Mihirung/Dominoid/output/dominoid_A_face.png

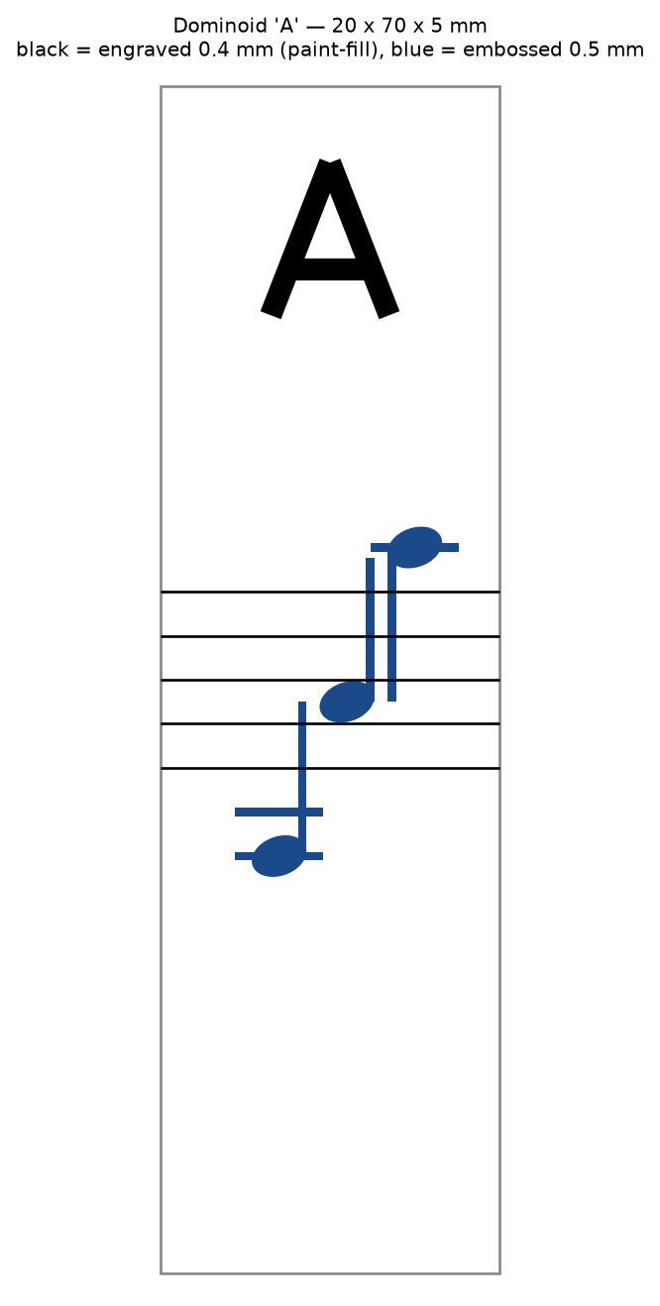
output/dominoid_A_face.png
