Mihirung/Dominoid/output/dominoid_B_flat_face.png

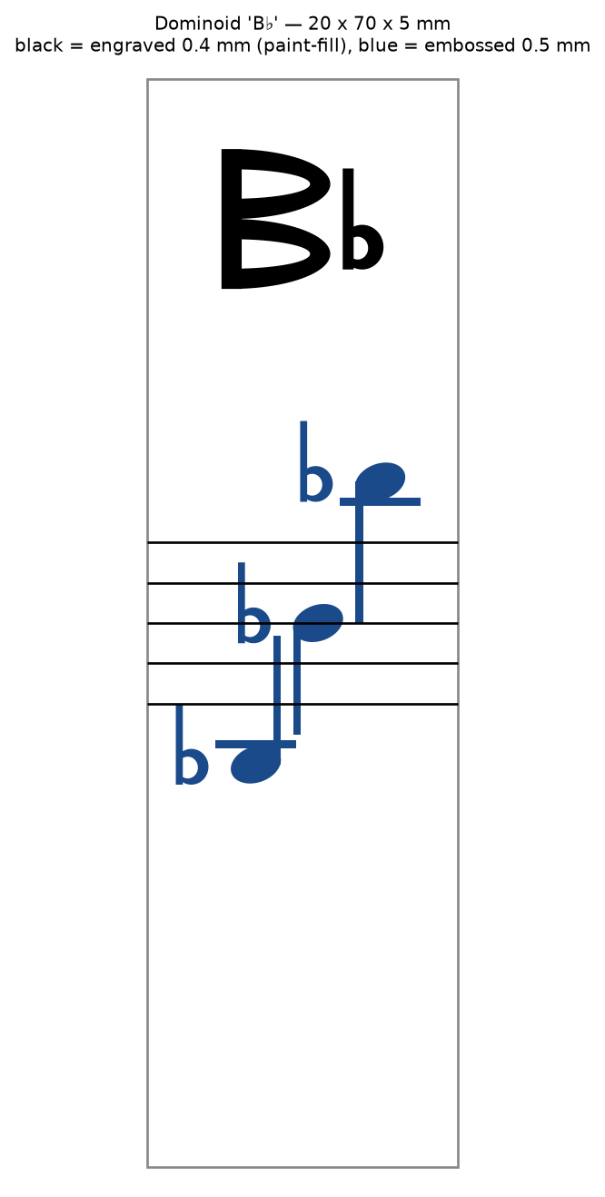
output/dominoid_B_flat_face.png
