Mihirung/Dominoid/output/dominoid_C_face.png

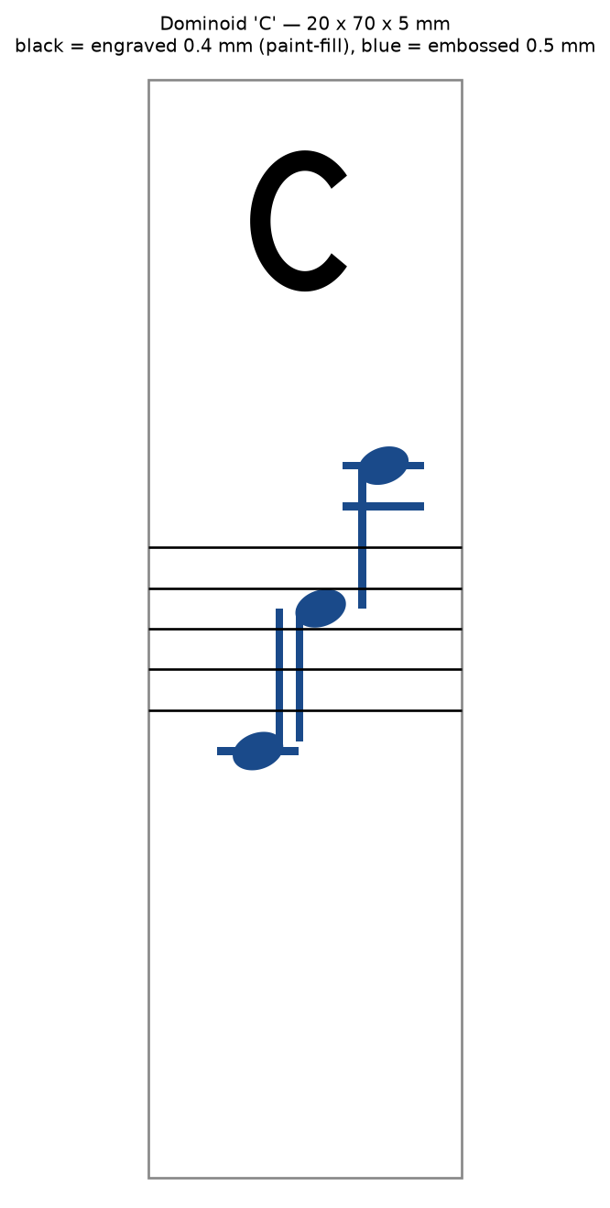
output/dominoid_C_face.png
