Mihirung/Dominoid/output/dominoid_C_render.png

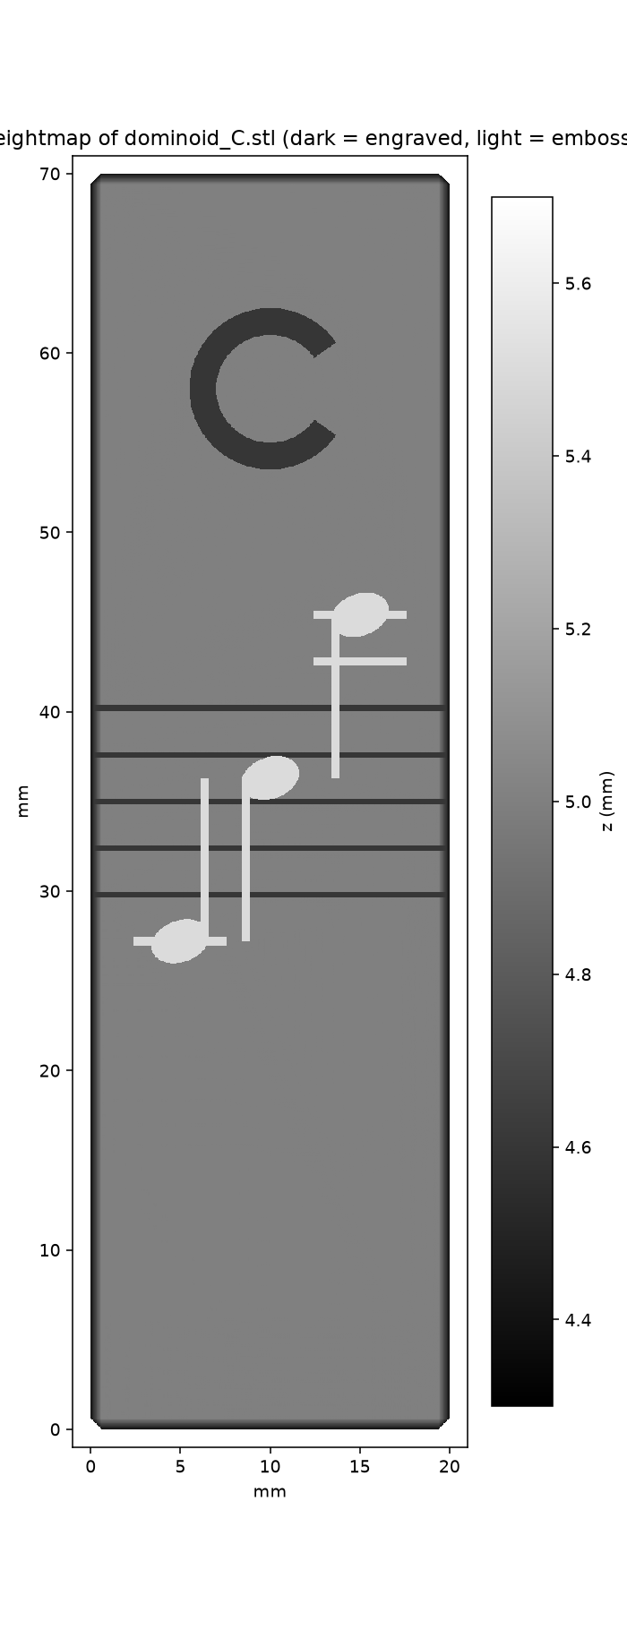
output/dominoid_C_render.png
