Mihirung/Dominoid/output/dominoid_C_sharp_face.png

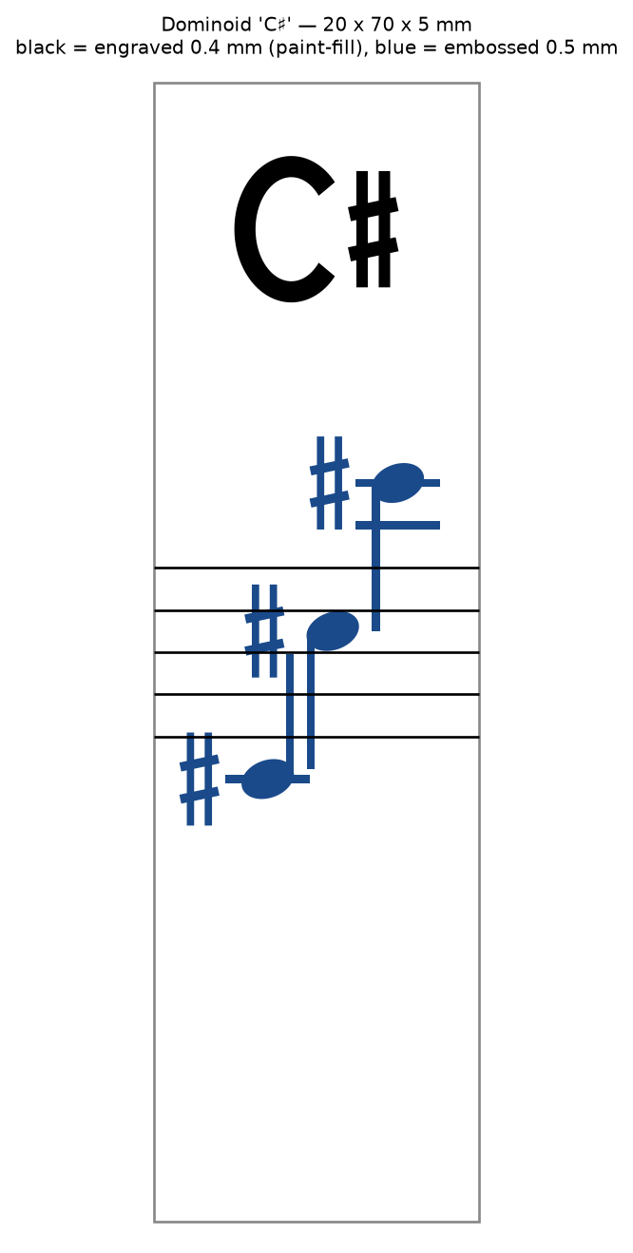
output/dominoid_C_sharp_face.png
