Mihirung/Dominoid/output/dominoid_D_face.png

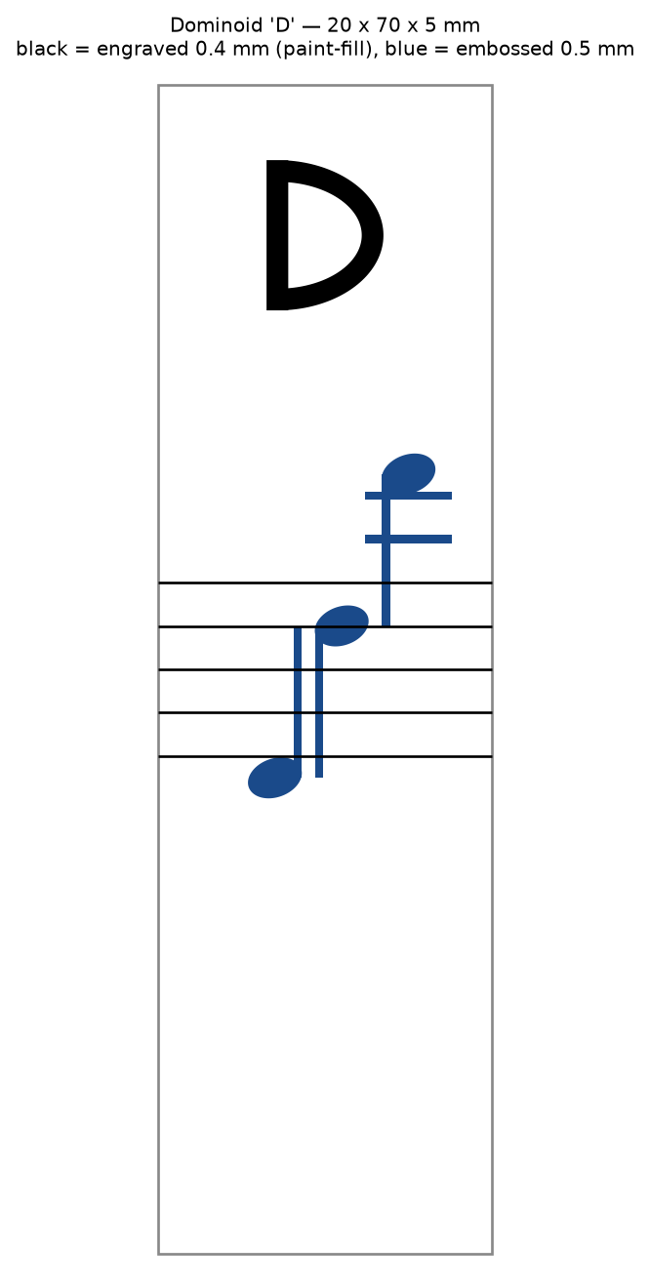
output/dominoid_D_face.png
