Mihirung/Dominoid/output/dominoid_D_sharp_face.png

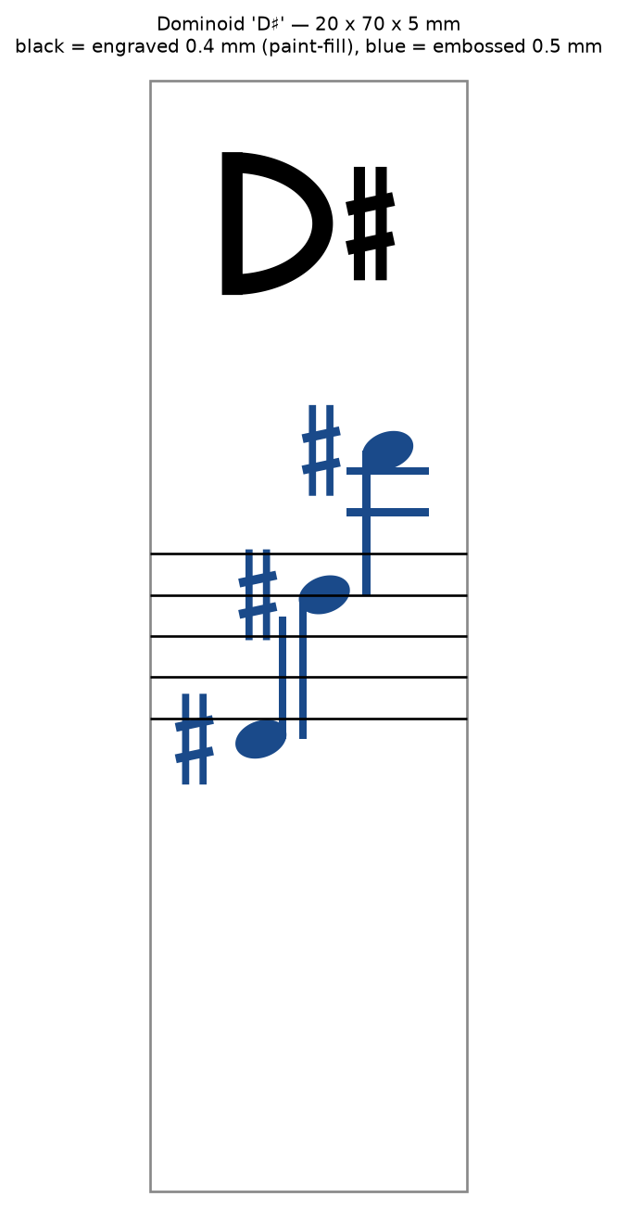
output/dominoid_D_sharp_face.png
