Mihirung/Dominoid/output/dominoid_F_double_sharp_face.png

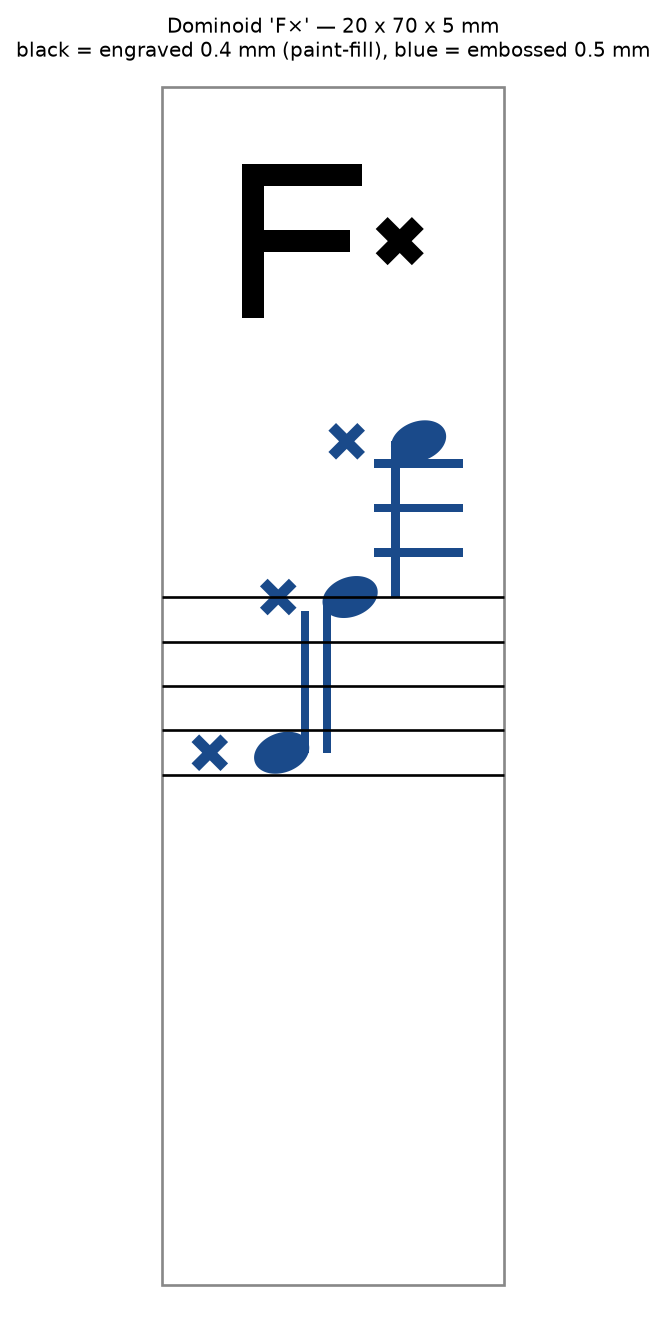
output/dominoid_F_double_sharp_face.png
