Mihirung/Dominoid/output/dominoid_F_sharp_face.png

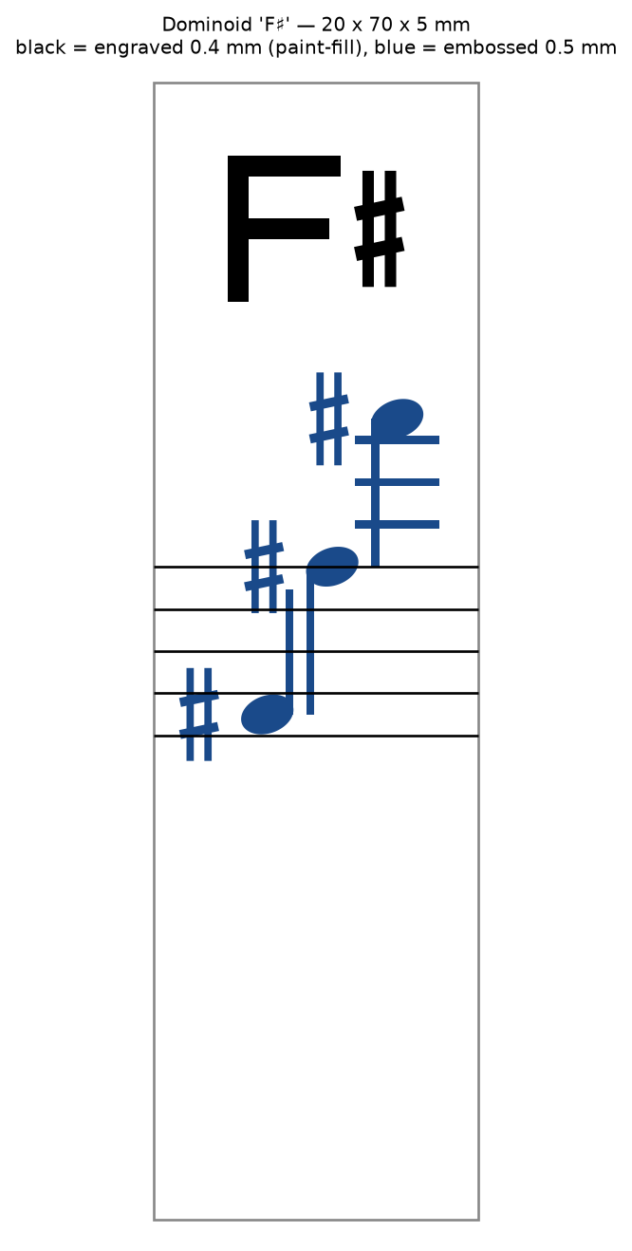
output/dominoid_F_sharp_face.png
