Mihirung/Dominoid/automaton/output/parts/lever.stl

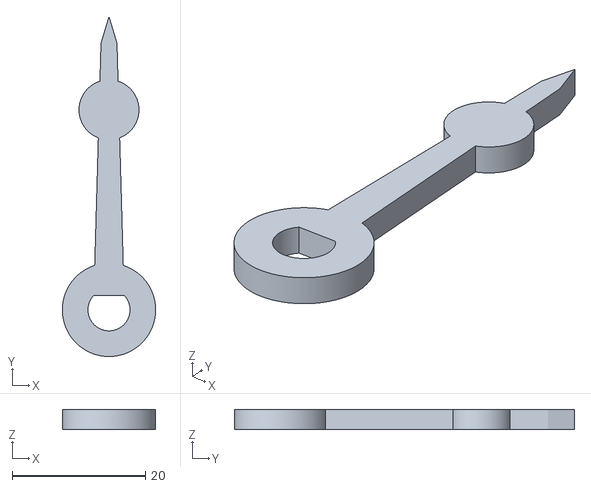
[picture p11: CAD file, 2026-09-08]
automaton/output/parts/lever.stl
14.0 x 51.0 x 3.00
