Mihirung/Dominoid/output/dominoid_C_sharp.stl

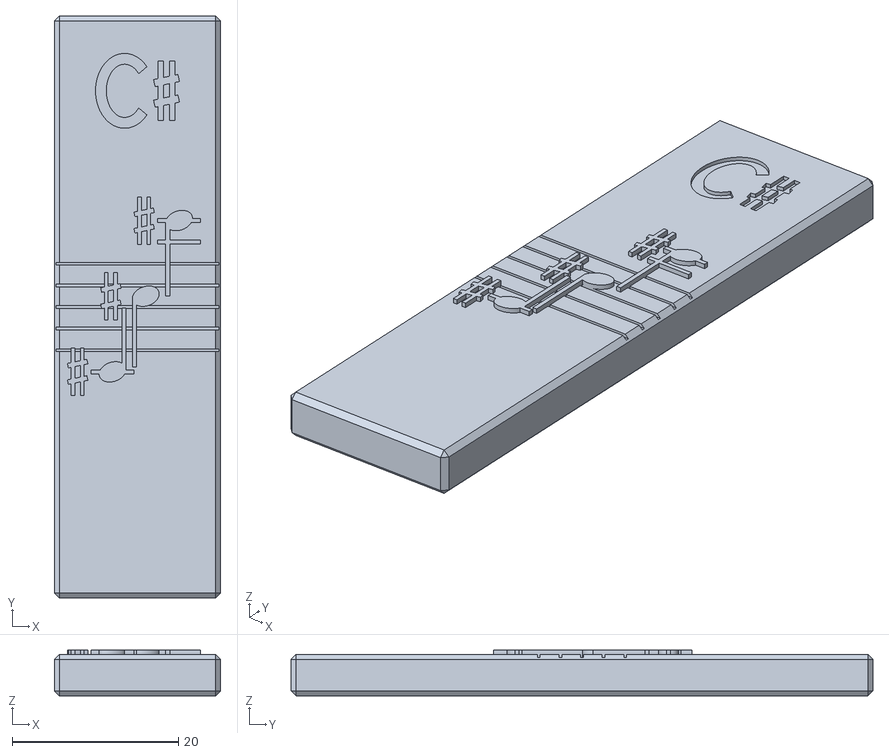
[picture p12: CAD file, 2026-09-19]
output/dominoid_C_sharp.stl
20.0 x 70.0 x 5.50
