Mihirung/Dominoid/automaton/output/parts/disc_T_tonic.stl

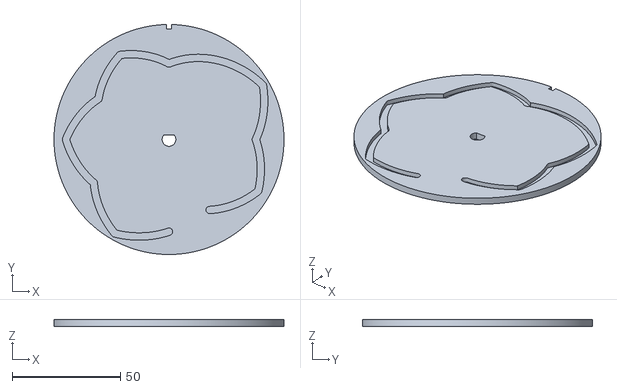
[picture p13: CAD file, 2026-09-08]
automaton/output/parts/disc_T_tonic.stl
106.0 x 106.0 x 3.00
