Mihirung/Dominoid/output/dominoid_F.stl

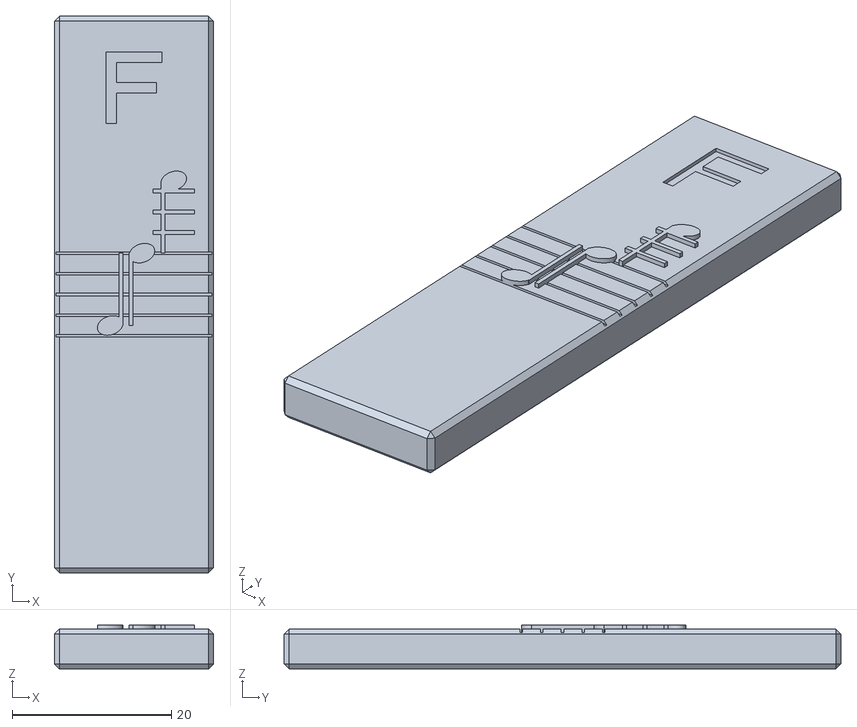
[picture p14: CAD file, 2026-09-19]
output/dominoid_F.stl
20.0 x 70.0 x 5.50
