Mihirung/Dominoid/automaton/output/parts/disc_F_flats.stl

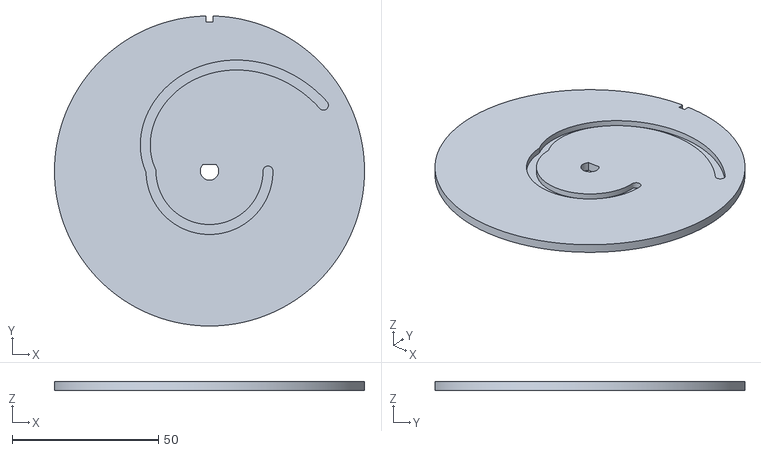
[picture p15: CAD file, 2026-09-08]
automaton/output/parts/disc_F_flats.stl
106.0 x 106.0 x 3.00
