Mihirung/Dominoid/automaton/output/parts/combS.stl

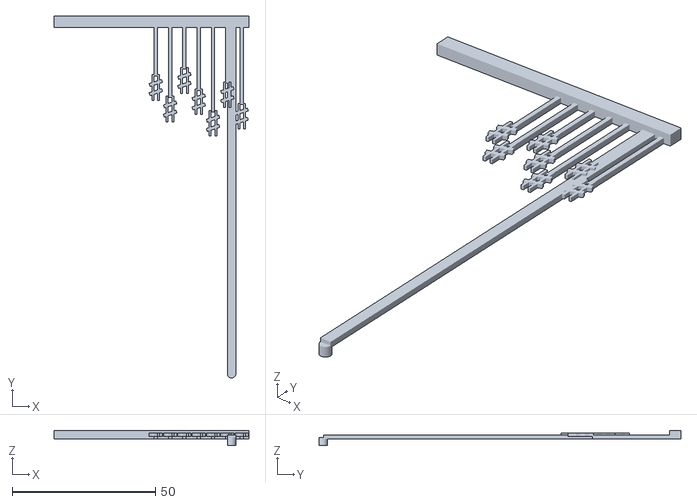
[picture p16: CAD file, 2026-09-08]
automaton/output/parts/combS.stl
68.0 x 126.5 x 5.20
