Mihirung/Dominoid/automaton/output/parts/front_panel.stl

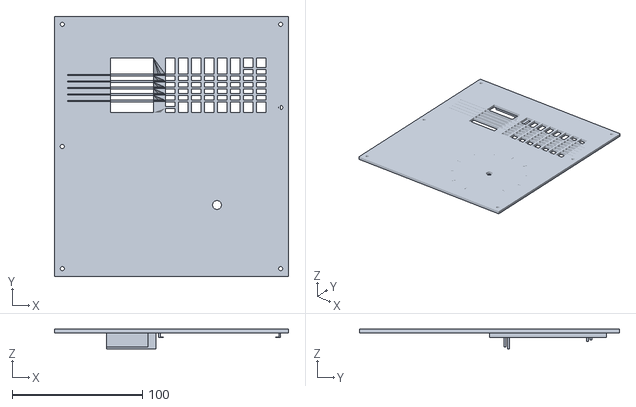
[picture p17: CAD file, 2026-09-08]
automaton/output/parts/front_panel.stl
180.0 x 200.0 x 15.2
