Mihirung/Dominoid/automaton/output/parts/base_plate.stl

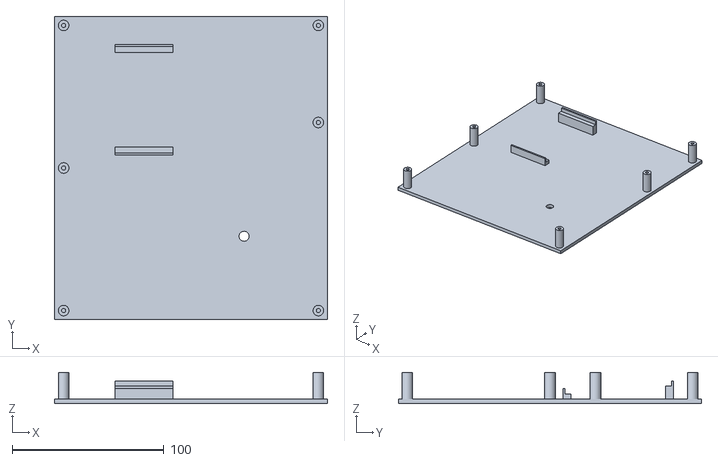
[picture p18: CAD file, 2026-09-08]
automaton/output/parts/base_plate.stl
180.0 x 200.0 x 20.5
