Mihirung/Dominoid/automaton/output/parts/carriage.stl

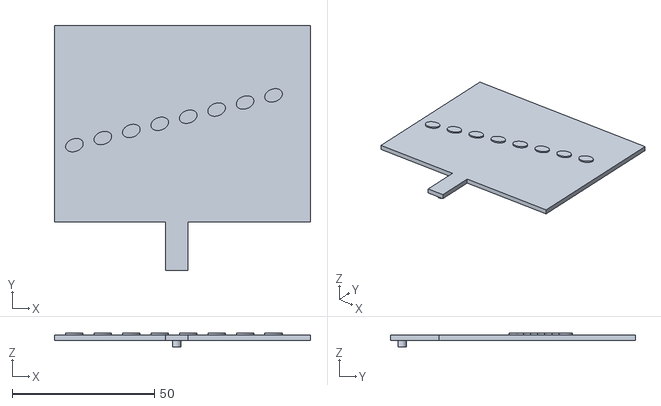
[picture p19: CAD file, 2026-09-08]
automaton/output/parts/carriage.stl
90.0 x 86.0 x 4.80
