Mihirung/Dominoid/automaton/output/parts/shaft.stl

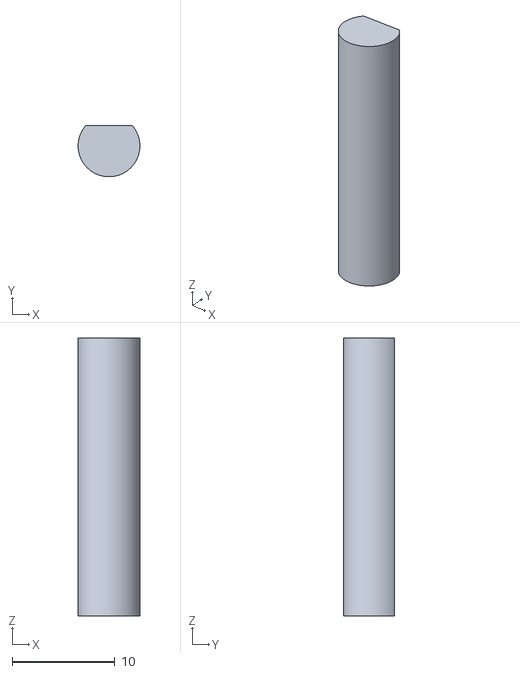
[picture p20: CAD file, 2026-09-08]
automaton/output/parts/shaft.stl
6.00 x 5.00 x 27.0
