Mihirung/Dominoid/automaton/output/parts/spacer_3p5.stl

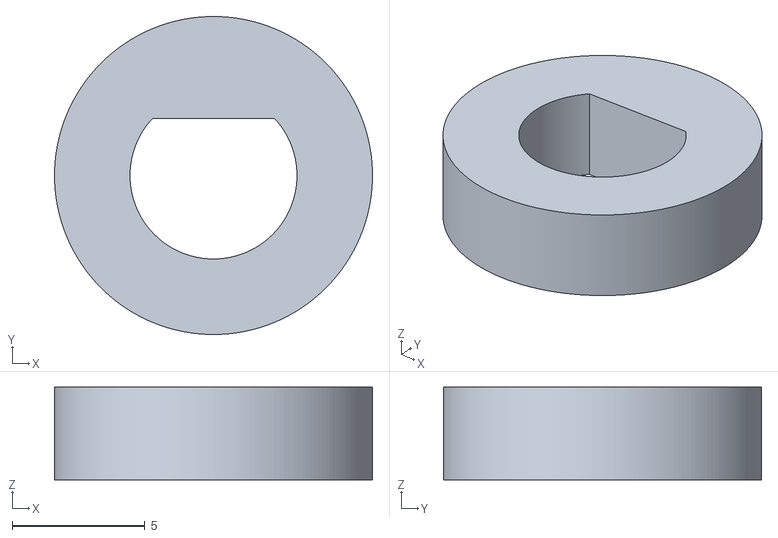
[picture p21: CAD file, 2026-09-08]
automaton/output/parts/spacer_3p5.stl
12.0 x 12.0 x 3.50
