Mihirung/Dominoid/automaton/output/parts/spacer_2p5_x2.stl

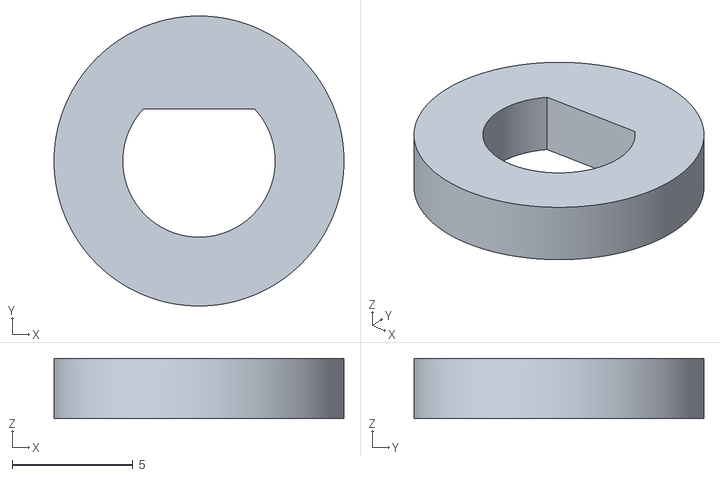
[picture p22: CAD file, 2026-09-08]
automaton/output/parts/spacer_2p5_x2.stl
12.0 x 12.0 x 2.50
