Mihirung/Dominoid/automaton/output/parts/combF.stl

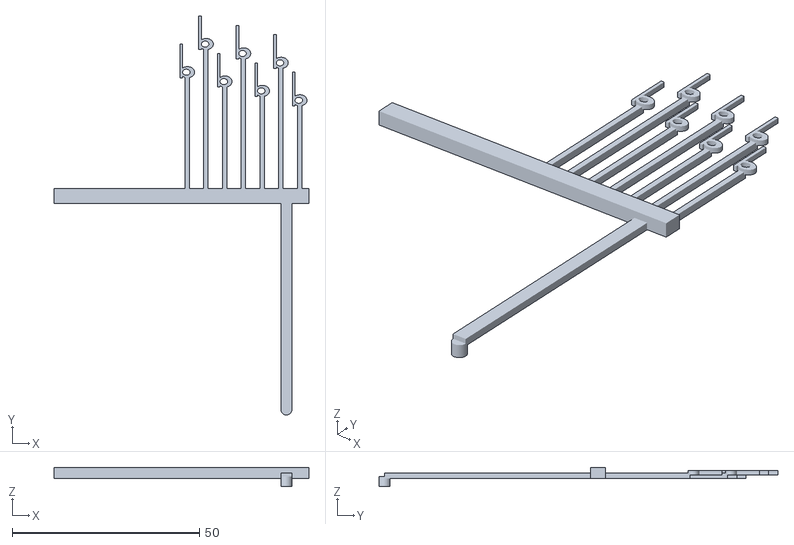
[picture p23: CAD file, 2026-09-08]
automaton/output/parts/combF.stl
68.0 x 106.5 x 5.20
