Mihirung/Dominoid/(list of files, cad)

Other CAD files:
output/dominoid_A_flat.stl
output/dominoid_C.stl
automaton/output/parts/disc_S_sharps.stl
output/dominoid_E_flat.stl
output/dominoid_F_flat.stl
output/dominoid_D.stl
output/dominoid_G_sharp.stl
output/dominoid_A.stl
output/dominoid_B.stl
output/dominoid_D_flat.stl
output/dominoid_D_sharp.stl
output/dominoid_B_flat.stl
output/dominoid_G.stl
output/dominoid_E_sharp.stl
output/dominoid_B_sharp.stl
output/dominoid_E.stl
output/dominoid_A_sharp.stl
output/dominoid_C_flat.stl
output/dominoid_F_sharp.stl
output/dominoid_F_double_sharp.stl
output/dominoid_G_flat.stl
output/dominoid_A.obj
output/dominoid_A_flat.obj
output/dominoid_A_sharp.obj
output/dominoid_B.obj
output/dominoid_B_flat.obj
output/dominoid_B_sharp.obj
output/dominoid_C.obj
output/dominoid_C_flat.obj
output/dominoid_C_sharp.obj
output/dominoid_D.obj
output/dominoid_D_flat.obj
output/dominoid_D_sharp.obj
output/dominoid_E.obj
output/dominoid_E_flat.obj
output/dominoid_E_sharp.obj
output/dominoid_F.obj
output/dominoid_F_double_sharp.obj
output/dominoid_F_flat.obj
output/dominoid_F_sharp.obj
output/dominoid_G.obj
output/dominoid_G_flat.obj
output/dominoid_G_sharp.obj
