Mihirung/Dominoid/automaton/output/assembly_proof.png

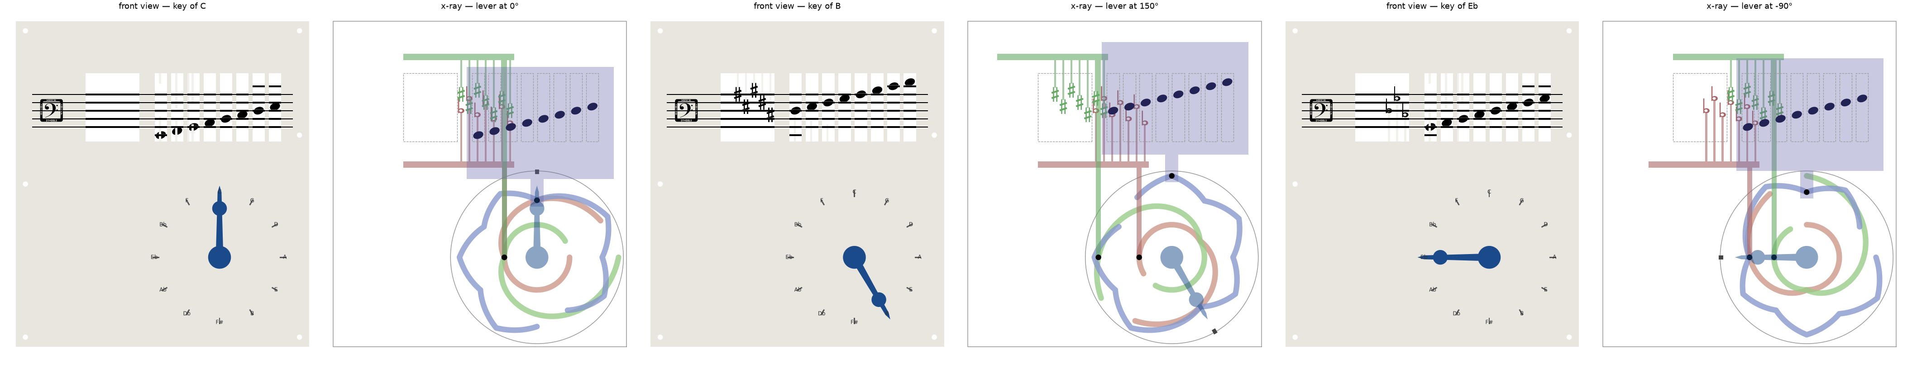
automaton/output/assembly_proof.png
