Mihirung/Dominoid/(commit log)

2026-09-08 Add parametric musical domino generator and C-tile prototype
    70 x 20 x 10 mm resin-printable tile: five-line staff engraved 0.4 mm
    edge to edge for black paint-fill, embossed crotchets (0.5 mm) showing
    C4, C5 and C6 in treble clef with ledger lines and correct stem
    directions, and an engraved capital C heading. dominoid.py generates
    any natural-note tile from staff-position arithmetic; outputs include
    the STL, a 2D design proof and a heightmap verification render.
    Claude-Session: https://claude.ai/code/session_01BV7qZzFUGkvdauToQyDJZm
    [dominoid_C.stl]
2026-09-08 Flip the tile portrait: 20 wide x 70 high x 5 thick
    Per the designer's feedback, tiles now stand portrait so a row of them
    chains the staff across the 20 mm width and an eight-note scale fits in
    about 16 cm. The three octave crotchets ascend left to right in columns
    5 mm apart at a larger staff gauge (2.6 mm spaces), with stems trimmed
    automatically if they would touch a neighbouring glyph. Heading letter
    enlarged to suit the taller face; outputs regenerated.
    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
    [dominoid_C.stl]
2026-09-08 Add the scale automaton: cam-driven circle-of-fifths scale engine
    A panel with a staff and a lever sweeping the circle of fifths. Three
    cam discs on the lever shaft drive a scale carriage (tonic groove, 0 to
    15 mm lift) and two glyph combs (spiral grooves, one sharp or flat per
    step), so the major scale rebuilds itself as the lever turns; the
    grooves end at F sharp and D flat, which is the mechanical stop.
    automaton/geometry.py holds every part as 2D shapes plus the follower
    functions; proof.py draws front and x-ray assembly views per key;
    build.py exports the discs, carriage, combs, shaft, spacers, lever and
    the two 180 x 200 mm sheets as STL, with the sheets also as SVG for
    laser or hand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
    [base_plate.stl, carriage.stl, combF.stl, combS.stl, disc_F_flats.stl, disc_S_sharps.stl, disc_T_tonic.stl, front_panel.stl]
2026-09-19 Complete the tile set: seven natural notes with real A-G headings
    Adds D, E, F, G, A and B alongside the C prototype. Three fixes were
    needed to make a set rather than one tile:
    - The heading glyph was hard-coded as a C, so every tile would have
    printed with a C at the top. Replaced with a geometric A-G alphabet
    built from bars, stems and elliptical annulus sectors, sharing one
    weight and width; stroke lightened to 1.3 mm so B's counters stay open.
    - The G spur met its arc at a single point, producing a degenerate
    polygon that would not extrude to a solid. It now overlaps the arc end.
    - Embossed glyphs were unioned as overlapping prisms, which left ramp
    slivers where their walls i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
    [dominoid_A.stl, dominoid_B.stl, dominoid_C.stl, dominoid_D.stl, dominoid_E.stl, dominoid_F.stl, dominoid_G.stl]
2026-09-19 Add accidental tiles: the full 21-tile set, plus F double sharp
    Extends the generator to sharps and flats, so every note name a scale
    can call for has a tile. A full set is 21: seven letters as natural,
    sharp and flat, exported as both STL and OBJ.
    - Accidental glyphs (sharp, flat, double sharp, double flat) drawn to
    the staff gauge and embossed to the left of each notehead; the
    heading becomes the letter plus its accidental.
    - The accidental slot is reserved on every tile, naturals included, so
    noteheads sit at the same x across the set and a laid-out scale keeps
    an even spacing. Columns moved to 4 mm apart to make room.
    - Headings dropped to y=61 so a high flat clears them.
    tools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
    [dominoid_A.obj, dominoid_A.stl, dominoid_A_flat.obj, dominoid_A_flat.stl, dominoid_A_sharp.obj, dominoid_A_sharp.stl, dominoid_B.obj, dominoid_B.stl]
